DougTownsend/ece212-project3/kicad/p3_schematic.pdf

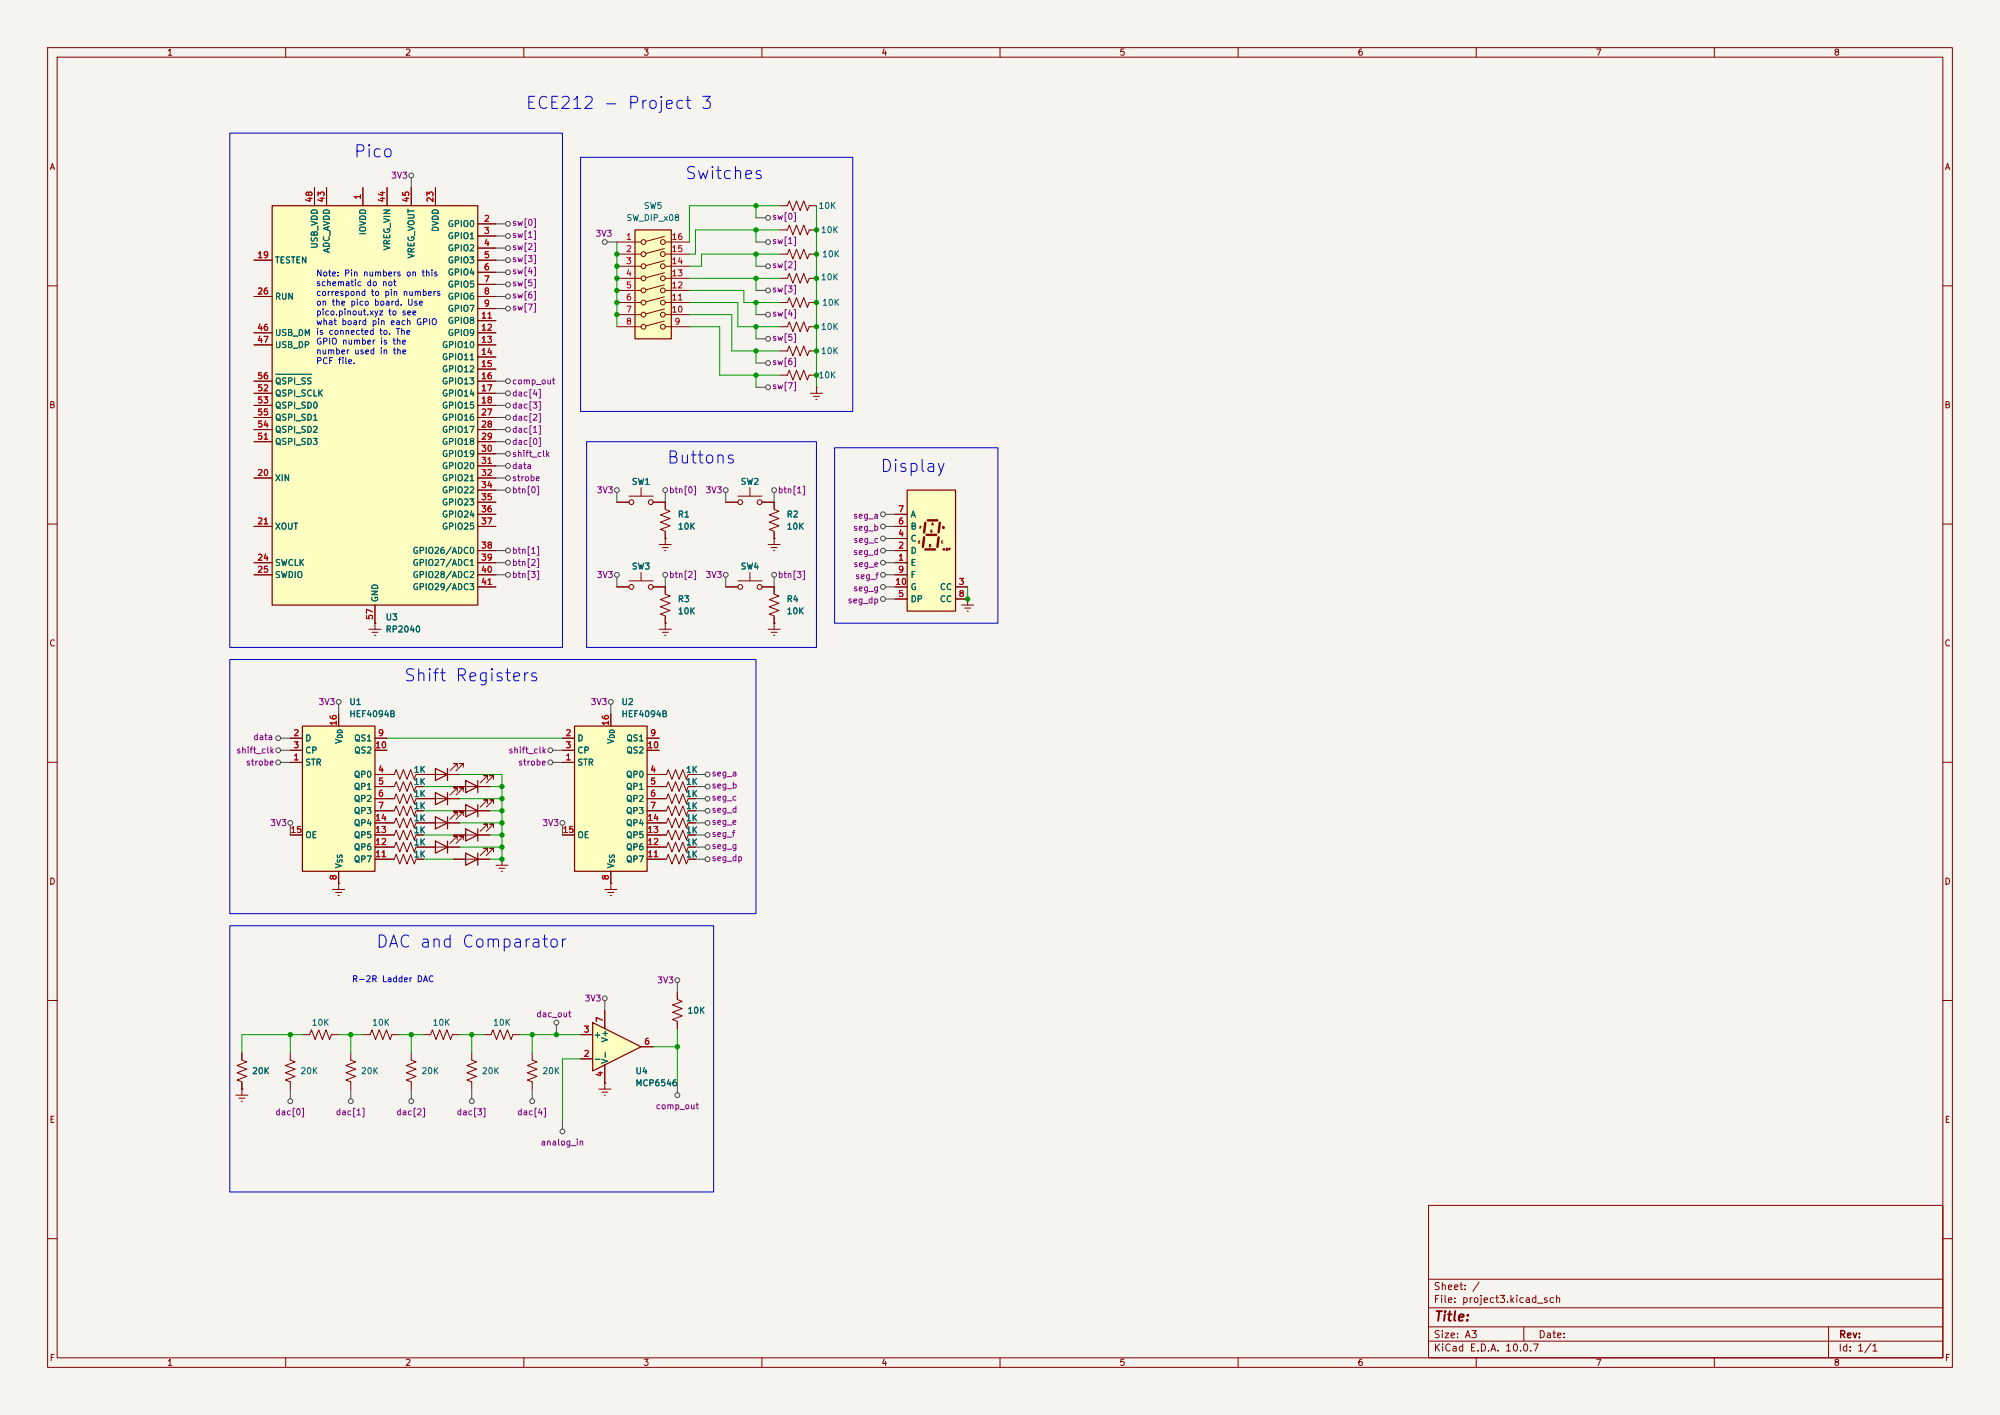
[picture p5: page 1]

is connected to. The GPIO number is the number used in the PCF file.Pico

R-2R Ladder DAC DAC and Comparator

Size: A3 | Rev:
KiCad E.D.A. 10.0.7 | Id: 1/1
