DougTownsend/ece212-project3/kicad/project3.kicad_pcb

## KiCad design VANAAR/VANAAR.kicad_sch


Parts:
C7, C8: 22pF
C9, C10, C11, C12: 100nF
D1: 10V
F1: Fuse
J1: Battery input
J2: BTS7960_1_MOTOR_PWR
J3: BTS7960_2_MOTOR_PWR
J4, J5, J8: Left BTS7960 control
J6: Steering Servo 1
J7: BTS7960_3_MOTOR_PWR
J10: 5 V buck input
J11: 5 V buck output
J12: 6.2 V buck input
J13: Servo buck output
J14: Steering Servo 2
J15: Steering Servo 3
J16: Steering Servo 4
Q2: Q_PMOS_GDS
R1: 100K
R2, R3, R4, R5, R6, R7: 10K
R10: 1M
R11: R
U1: ATmega2560-16A; TQFP-100_14x14mm_P0.5mm
Y2: 16Mhz

Connections:
BAT_PROT: J2.1, J3.1, J7.1, J10.1, J12.1, Q2.2 (D)
D3_LEN: J8.3, R7.1, U1.73 (PA5)
D3_LPWM: J8.5, U1.25 (PB6)
D3_REN: J8.4, R6.1, U1.74 (PA4)
D3_RPWM: J8.6, U1.24 (PB5)
GND: C7.1, C8.1, C9.1, C10.1, C11.1, C12.1, J1.2, J2.2, J3.2, J4.1, J5.1, J6.3, J7.2, J8.1, J10.2, J11.2, J12.2, J13.2, J14.3, J15.3, J16.3, R1.2, R2.2, R3.2, R4.2, R5.2, R6.2, R7.2, U1.11 (GND), U1.32 (GND), U1.62 (GND), U1.81 (GND), U1.99 (GND)
LOGIC_5V: C10.2, C11.2, C12.2, J4.2, J5.2, J8.2, J11.1, U1.10 (VCC), U1.31 (VCC), U1.61 (VCC), U1.80 (VCC), U1.100 (AVCC)
L_LEN: J4.3, R3.1, U1.77 (PA1)
L_LPWM: J4.5, U1.15 (PH3)
L_REN: J4.4, R2.1, U1.78 (PA0)
L_RPWM: J4.6, U1.5 (PE3)
unnamed: C7.2, R10.2, R11.1, Y2.1
unnamed: C8.2, R10.1, U1.34 (XTAL1), Y2.2
unnamed: C9.2, U1.98 (AREF)
unnamed: D1.1 (K), F1.1, Q2.3 (S)
unnamed: D1.2 (A), Q2.1 (G), R1.1
unnamed: F1.2, J1.1
unnamed: R11.2, U1.33 (XTAL2)
R_LEN: J5.3, R5.1, U1.75 (PA3)
R_LPWM: J5.5, U1.23 (PB4)
R_REN: J5.4, R4.1, U1.76 (PA2)
R_RPWM: J5.6, U1.17 (PH5)
SERVO_6V2: J6.1, J13.1, J14.1, J15.1, J16.1
STEER_1_SIG: J6.2, U1.60 (PC7)
STEER_2_SIG: J14.2, U1.59 (PC6)
STEER_3_SIG: J15.2, U1.58 (PC5)
STEER_4_SIG: J16.2, U1.57 (PC4)

Notes on the sheet:
POWER INPUT & PROTECTION
Arduino Mega Chip
MOTOR DRIVERS
POWER DISTRIBUTION
STEERING SERVOS
